Keonnurse/esp32-wireless-scoreboard/cad/button_enclosure/button_panel.3mf

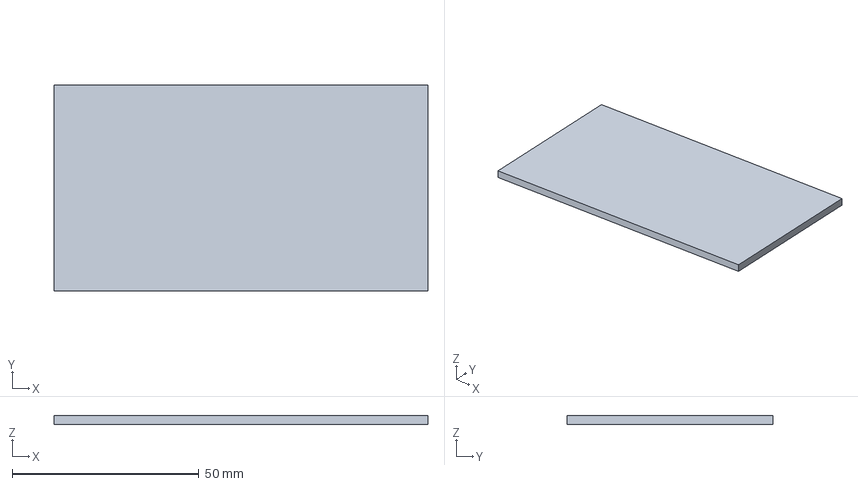
[picture p9: CAD file, 2026-10-20]
cad/button_enclosure/button_panel.3mf
100.0 x 55.1 x 2.50 mm
