Keonnurse/esp32-wireless-scoreboard/cad/button_enclosure/button_box.3mf

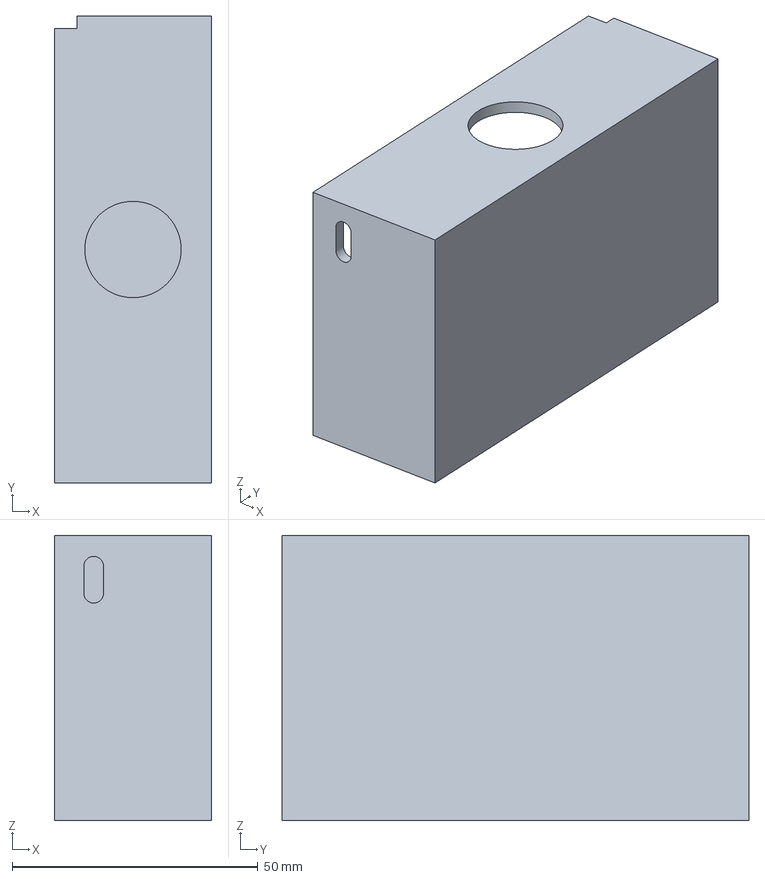
[picture p10: CAD file, 2026-10-20]
cad/button_enclosure/button_box.3mf
32.0 x 95.0 x 58.0 mm
