Keonnurse/esp32-wireless-scoreboard/(list of files, cad)

Other CAD files:
cad/button_enclosure/button_box.stl
cad/button_enclosure/button_panel.stl
