Keonnurse/esp32-wireless-scoreboard/docs/images/wiring/IMG_3097.jpeg

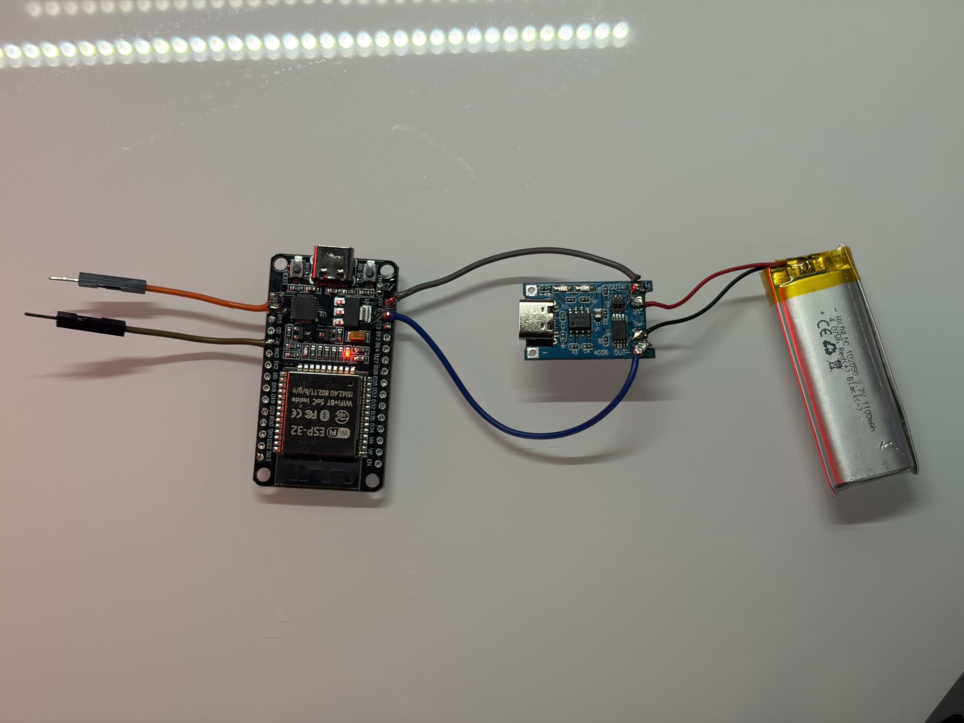
docs/images/wiring/IMG_3097.jpeg
