Keonnurse/esp32-wireless-scoreboard/(commit log)

2026-04-22 Initial upload: scoreboard receiver and two player button senders
2026-04-22 Revise README for ESP32 Wireless Scoreboard project
    Expanded README to provide detailed project overview, system architecture, hardware requirements, software dependencies, and known issues.
2026-10-19 Add CAD scripts, renders and wiring diagrams
2026-10-20 Add video to README for ESP32 project
2026-10-20 Create Button folder
2026-10-20 Updated README.md with wiring image
    Updated README.md with wiring image
2026-10-20 Update image widths in README wiring section
    Adjusted image widths in wiring section for better layout.
2026-10-20 Adjust image widths in Wiring section of README
    Increased the width percentages of wiring images in the README.
2026-10-20 Update image widths in README.md
    Adjusted image width for scoreboard stand and wiring sections.
2026-10-20 Revise stand printing instructions and image sizes
    Updated instructions for printing the stand and adjusted image width for clarity.
2026-10-20 Add CAD scripts and button folder, fix wiring diagram
2026-10-20 Move photos to photos/, new button diagram, README cleanup
